yeunk/Project_in_Visual_Computing/Final_project/heart_inner_solidify.stl

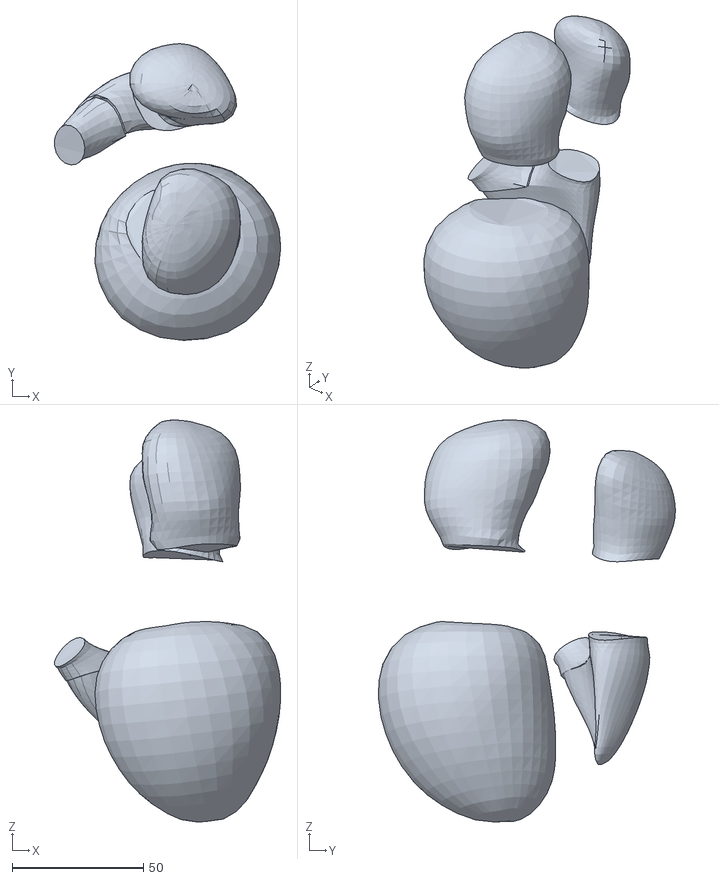
[picture p19: CAD file, 2026-02-13]
Final_project/heart_inner_solidify.stl
86.3 x 113.3 x 153.4
