yeunk/Project_in_Visual_Computing/Final_project/heart_outer_1.5thick.3mf

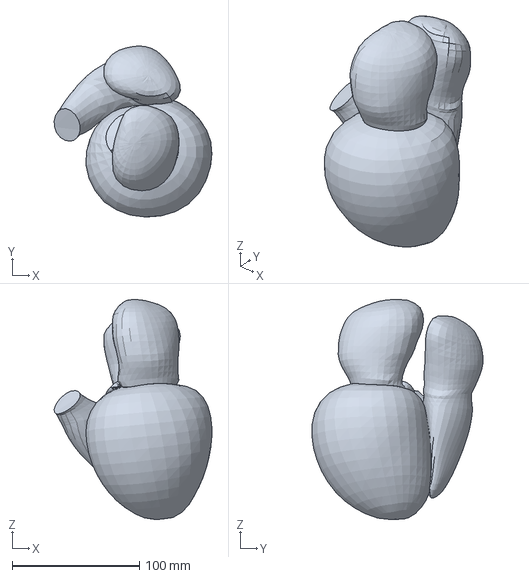
[picture p20: CAD file, 2026-02-13]
Final_project/heart_outer_1.5thick.3mf
124.1 x 134.7 x 173.1 mm
