yeunk/Project_in_Visual_Computing/(list of files, cad)

Other CAD files:
Final_project/Final_mesh.blend
Final_project/heart_outer_1.5thick.stl
